korsh624/TECHNOCAMP2022/files/GPS.jpg

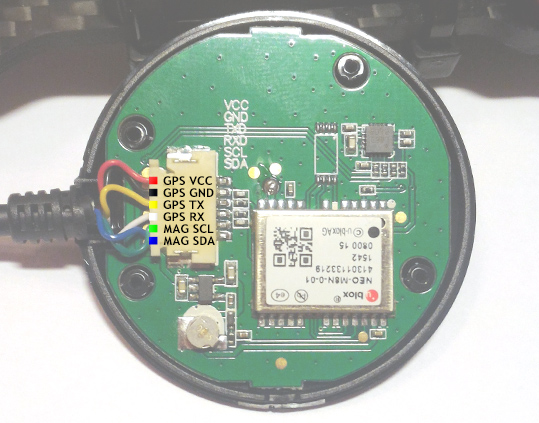
files/GPS.jpg
