korsh624/TECHNOCAMP2022/disign/задняя наклонная.dxf

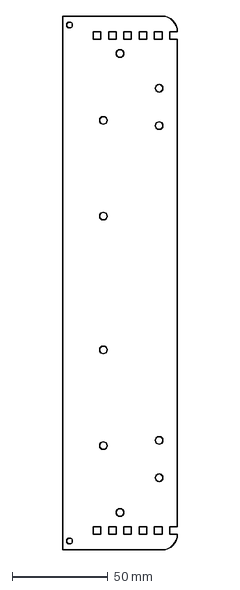
[picture p18: CAD file, 2022-04-28]
disign/задняя наклонная.dxf
60.0 x 279.0 mm
