korsh624/TECHNOCAMP2022/new/для драйвов.dxf

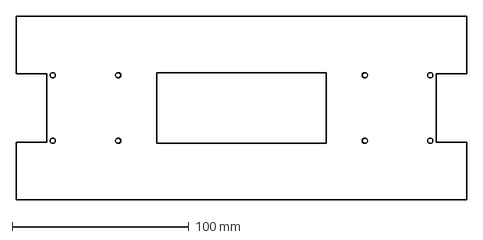
[picture p19: CAD file, 2022-04-28]
new/для драйвов.dxf
255.0 x 104.0 mm
