korsh624/TECHNOCAMP2022/disign/крышка наклонная.dxf

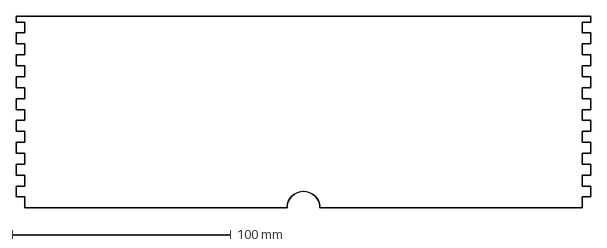
[picture p20: CAD file, 2022-04-28]
disign/крышка наклонная.dxf
263.0 x 87.7 mm
