korsh624/TECHNOCAMP2022/new/для аккума.dxf

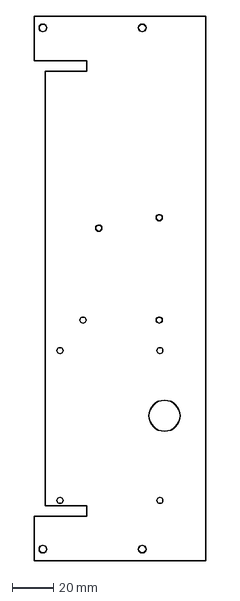
[picture p21: CAD file, 2022-04-28]
new/для аккума.dxf
83.0 x 263.0 mm
