korsh624/TECHNOCAMP2022/disign/задняя левая бок.dxf

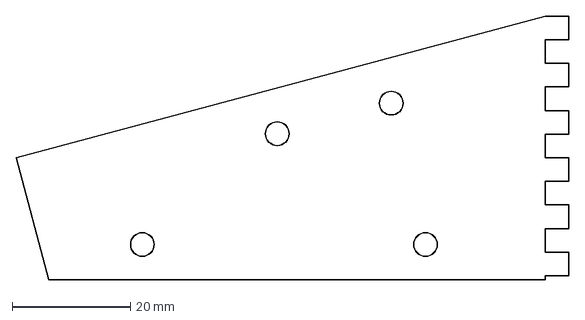
[picture p22: CAD file, 2022-04-28]
disign/задняя левая бок.dxf
93.6 x 44.7 mm
