korsh624/TECHNOCAMP2022/new/просто штука.dxf

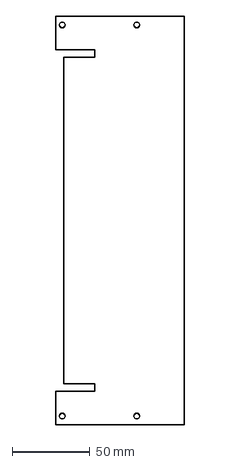
[picture p23: CAD file, 2022-04-28]
new/просто штука.dxf
83.0 x 263.0 mm
