korsh624/TECHNOCAMP2022/disign/задняя пластина.dxf

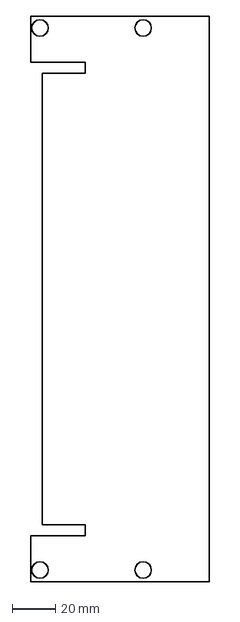
[picture p24: CAD file, 2022-04-28]
disign/задняя пластина.dxf
83.0 x 263.0 mm
