korsh624/TECHNOCAMP2022/disign/цент пластина.dxf

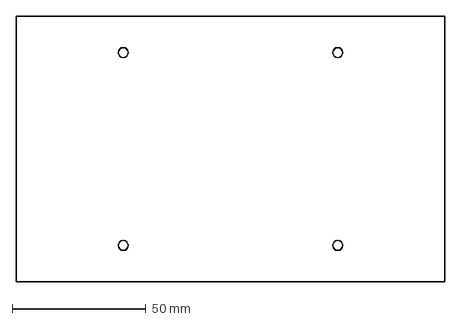
[picture p25: CAD file, 2022-04-28]
disign/цент пластина.dxf
160.0 x 99.0 mm
