korsh624/TECHNOCAMP2022/disign/централ левая.dxf

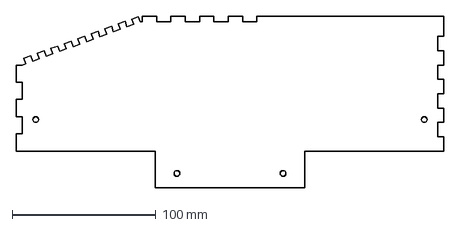
[picture p26: CAD file, 2022-04-28]
disign/централ левая.dxf
297.6 x 119.5 mm
