korsh624/TECHNOCAMP2022/disign/централ права.dxf

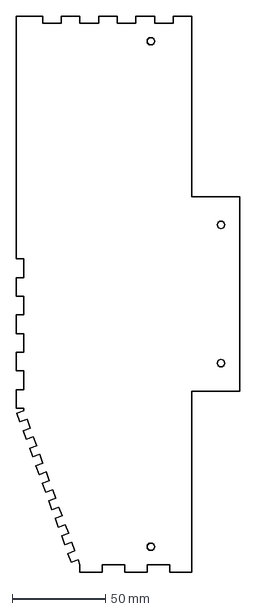
[picture p27: CAD file, 2022-04-28]
disign/централ права.dxf
119.5 x 297.6 mm
