korsh624/TECHNOCAMP2022/disign/крышка.dxf

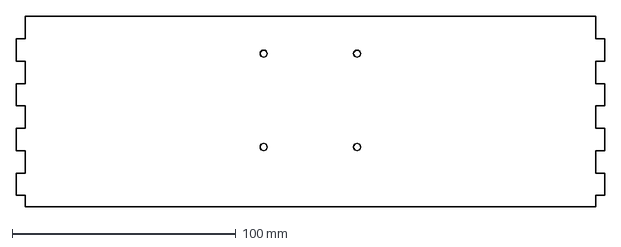
[picture p28: CAD file, 2022-04-28]
disign/крышка.dxf
263.0 x 85.0 mm
