korsh624/TECHNOCAMP2022/disign/плашка с дыркой для аккума.dxf

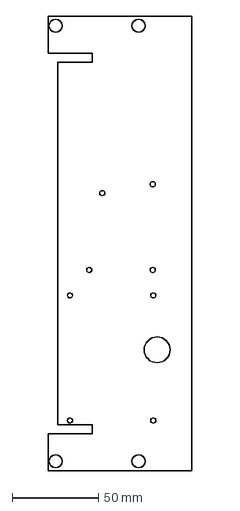
[picture p29: CAD file, 2022-04-28]
disign/плашка с дыркой для аккума.dxf
83.0 x 263.0 mm
