korsh624/TECHNOCAMP2022/disign/передняя правая бок.dxf

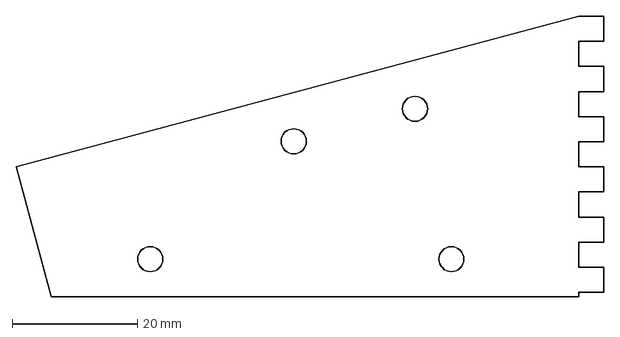
[picture p30: CAD file, 2022-04-28]
disign/передняя правая бок.dxf
93.6 x 44.7 mm
