korsh624/TECHNOCAMP2022/disign/лицевая вертикальная.dxf

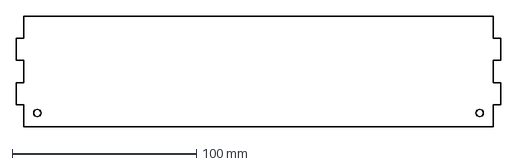
[picture p31: CAD file, 2022-04-28]
disign/лицевая вертикальная.dxf
263.0 x 60.0 mm
