korsh624/TECHNOCAMP2022/disign/центральная верхняя.dxf

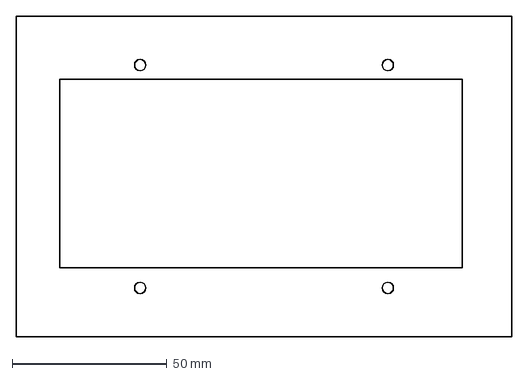
[picture p32: CAD file, 2022-04-28]
disign/центральная верхняя.dxf
160.0 x 103.6 mm
