korsh624/TECHNOCAMP2022/disign/передняя левая бок.dxf

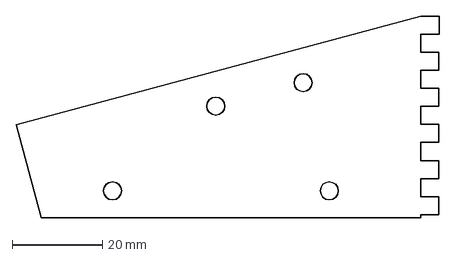
[picture p33: CAD file, 2022-04-28]
disign/передняя левая бок.dxf
93.6 x 44.7 mm
