korsh624/TECHNOCAMP2022/disign/задняя вертикальная.dxf

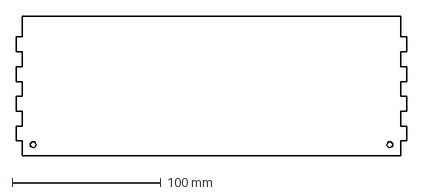
[picture p34: CAD file, 2022-04-28]
disign/задняя вертикальная.dxf
263.0 x 94.0 mm
