korsh624/TECHNOCAMP2022/disign/задняя правая бок.dxf

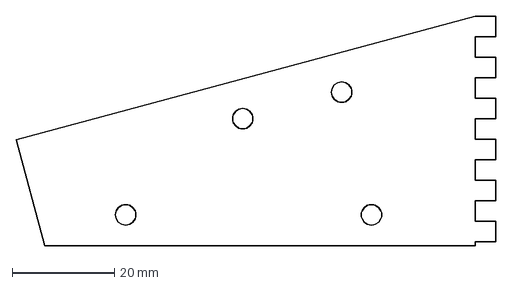
[picture p35: CAD file, 2022-04-28]
disign/задняя правая бок.dxf
93.6 x 44.7 mm
