korsh624/TECHNOCAMP2022/disign/площадка для драйверов.dxf

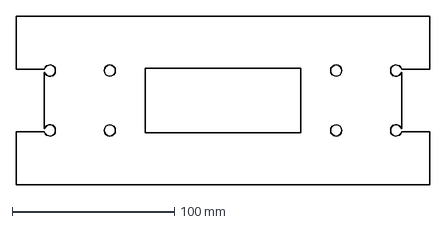
[picture p36: CAD file, 2022-04-28]
disign/площадка для драйверов.dxf
255.0 x 104.0 mm
