korsh624/TECHNOCAMP2022/(list of files, cad)

Other CAD files:
disign/OldVersions/balka tetrix.0001.ipt
disign/balka tetrix.ipt
disign/вшакькьькьк.ipt
files/KB33-046-004-001 - Центральная пластина.ipt
files/KB33-046-004-002 - Передняя пластина.ipt
files/KB33-046-004-003 - Задняя пластина.ipt
files/KB33-046-004-004 - Центральная верхняя пластина.ipt
files/KB33-046-004-005 - Лицевая наклонная пластина.ipt
files/KB33-046-004-006 - Задняя наклонная пластина.ipt
files/KB33-046-004-007 - Центральная левая боковая пластина.ipt
files/KB33-046-004-008 - Центральная правая боковая пластина.ipt
files/KB33-046-004-009 - Передняя левая боковая пластина.ipt
files/KB33-046-004-010 - Передняя правая боковая пластина.ipt
files/KB33-046-004-011 - Задняя правая боковая пластина.ipt
files/KB33-046-004-012 - Задняя левая боковая пластина.ipt
files/KB33-046-004-014 - Лицевая вертикальня пластина.ipt
files/KB33-046-004-015 - Задняя вертикальня пластина.ipt
files/KB33-046-004-016 - Крышка.ipt
files/KB33-046-004-017 - Крышка наклонная.ipt
files/KB33-046-004-019 - Площадка под драйверы.ipt
files/OldVersions/KB33-046-004-002 - Передняя пластина.0010.ipt
