korsh624/TECHNOCAMP2022/LASER.INI

[Technics_Laser_Data]
ModifyTechCFG=0
LayersNumber=1
ExportRows=1
ExportColumns=1
ExportRowSpace=0.00000
ExportColumnSpace=0.00000
ExportRowCW=0.00000
ExportColumnCW=0.00000
LogicOrgPositionX=754.94193
LogicOrgPositionY=570.71641
LogicOrgPositionZ=-9999999.00000
AtOnceExport=1
IsTwoLaserWorking=1
TableZeroPositionX=0.00000
TableZeroPositionY=0.00000
OutputTimes=1
DelayTime=0
FeedLength=0.00000
FeedSpeed=5.00000
FeedDelayTime=0
MinX=51.22862
MaxX=754.94193
MinY=47.14829
MaxY=570.71641
ChangeSerialNo=0
ArrayMinX=51.22862
ArrayMaxX=754.94193
ArrayMinY=47.14829
ArrayMaxY=570.71641
ClipBoxPower=40.00000
ClipBoxPower2=40.00000
ClipBoxOffsetLen=2.00000
ClipBoxSpeed=25.00000
AlignMachineZPos=0.00000
RouteLength=0.00000
RoutePointNumber=0
OffsetLaserPower=0.00000
OffsetWorkSpeedPer=1.00000
ZHeightForLaserFocus=0.00000
LayerColor_0=0
OneWorkNeedTimes=72
TotalWorkTimes=0
[CoordSystem_0]
LogicOrgPosition1=754.94193
LogicOrgPosition2=570.71641
LogicOrgPosition3=-9999999.00000
SPLITBLOCK_NUMBER=2
SPLITBLOCK_NUMBER_0=0.00000
SPLITBLOCK_NUMBER_1=100000.00000
[CreateTechnicsCodeMgr]
PrjHasModifyCFG=1
[TechnicsLayers_0]
TechnicsMode=TECHNICS_LASERCUT
LaserCutConnerPower=100.00000
LaserCutWorkPower=100.00000
LaserCutConnerPower2=30.00000
LaserCutWorkPower2=50.00000
LaserCutFrequency=20000
LaserCutOptimizePathType=1
LaserCutInnerToOuter=1
LaserCutInnerToOuter2=0
LaserCutDownToUpper=0
LaserCutBlockHeight=150.00000
LaserCutAutoSetPathDir=1
LaserCutCicleMinSegNumber=36
LaserCutDisperseLength=0.10000
LaserCutCloseGapLength=0.00000
LaserCutOverlapLength=0.00000
LaserCutAdjustForClose=1
LaserCutQXEnterLength=0.00000
LaserCutDelayMoveTime=0.00000
LaserCutOpenGZDelayTime=0.00000
LaserCutOpenLaserDelayTime=0.00000
LaserCutCloseLaserDelayTime=0.00000
LaserCutDelayTimeAfterCloseLaser=0.00000
LaserCutOneAxisBackLashLength=0.00000
LaserCutTwoAxisBackLashLength=0.00000
LaserCutBackLashAddSpaceLength=8.00000
LaserCutBlowGasType=2
LaserCutAheadBlowGasTimes=0.00000
LaserCutNoCloseGasTimes=0.00000
LaserCutSpeed=8.00000
LaserCutGWAcc=3000.00000
LaserCutGWTime=0.01000
LaserCutTrackSize=100
LaserCutLineLength=0.00000
SpaceCutLineLength=0.00000
bSpaceLineFirst=0
LaserCutAdjustMove=0
LaserCutAdjustMoveDelay=0.00000
LaserCutUpLen=0.00000
LaserCutCircleSpeedNum=1
LaserCutCircleSpeed0_MinR=0.00000
LaserCutCircleSpeed0_MaxR=5.00000
LaserCutCircleSpeed0_Speed=10.00000
GROUP_ROWS_0=1
GROUP_COLUMNS_0=1
GROUP_ROWSPACE_0=0.00000
GROUP_COLUMNSPACE_0=0.00000
GROUP_ROWCWSPACE_0=0.00000
GROUP_COLUMNCWSPACE_0=0.00000
GROUP_MINX_0=51.22862
GROUP_MAXX_0=754.94193
GROUP_MINY_0=47.14829
GROUP_MAXY_0=570.71641
[TechnicsLayers_5987163]
TechnicsMode=TECHNICS_LASERCUT
LaserCutConnerPower=100.00000
LaserCutWorkPower=100.00000
LaserCutConnerPower2=30.00000
LaserCutWorkPower2=50.00000
LaserCutFrequency=20000
LaserCutOptimizePathType=1
LaserCutInnerToOuter=1
LaserCutInnerToOuter2=0
LaserCutDownToUpper=0
LaserCutBlockHeight=150.00000
LaserCutAutoSetPathDir=1
LaserCutCicleMinSegNumber=36
LaserCutDisperseLength=0.10000
LaserCutCloseGapLength=0.00000
LaserCutOverlapLength=0.00000
LaserCutAdjustForClose=1
LaserCutQXEnterLength=0.00000
LaserCutDelayMoveTime=0.00000
LaserCutOpenGZDelayTime=0.00000
LaserCutOpenLaserDelayTime=0.00000
LaserCutCloseLaserDelayTime=0.00000
LaserCutDelayTimeAfterCloseLaser=0.00000
LaserCutOneAxisBackLashLength=0.00000
LaserCutTwoAxisBackLashLength=0.00000
LaserCutBackLashAddSpaceLength=8.00000
LaserCutBlowGasType=2
LaserCutAheadBlowGasTimes=0.00000
LaserCutNoCloseGasTimes=0.00000
LaserCutSpeed=5.00000
LaserCutGWAcc=3000.00000
LaserCutGWTime=0.01000
LaserCutTrackSize=100
LaserCutLineLength=0.00000
SpaceCutLineLength=0.00000
bSpaceLineFirst=0
LaserCutAdjustMove=0
LaserCutAdjustMoveDelay=0.00000
LaserCutUpLen=0.00000
LaserCutCircleSpeedNum=1
LaserCutCircleSpeed0_MinR=0.00000
LaserCutCircleSpeed0_MaxR=5.00000
LaserCutCircleSpeed0_Speed=10.00000
GROUP_ROWS_0=1
GROUP_COLUMNS_0=1
GROUP_ROWSPACE_0=0.00000
GROUP_COLUMNSPACE_0=0.00000
GROUP_ROWCWSPACE_0=0.00000
GROUP_COLUMNCWSPACE_0=0.00000
GROUP_MINX_0=888.77780
GROUP_MAXX_0=937.64780
GROUP_MINY_0=468.88516
GROUP_MAXY_0=517.75506
